Ineltek-IT/Mx51Fx9AE-Breakout-board/README.md

# Mx51Fx9AE-Breakout-board
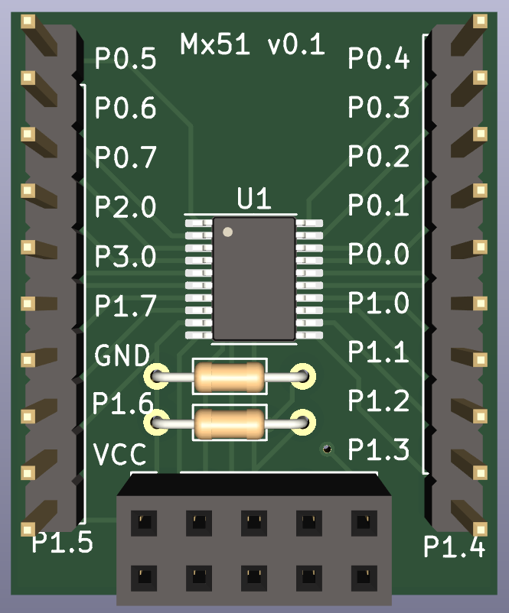
[picture p1: images/rendering.png]
Nuvoton breakout board rendering
Breakout board for Nuvoton's 8bit TTSOP MCUs, especially MS51FB9AE and MG51FB9AE
